MarioLulab/electronic_piano/HARDWARE/adc.c

#include "adc.h"



/*
                        光敏电阻
    PA1(ADC1/2_IN1) -> 电阻3
    PA3(ADC1/2_IN3) -> 电阻2
    PA4(ADC1/2_IN4) -> 电阻1
    PA5(ADC1/2_IN5) -> 电阻0

    初始化ADC
    不开启通道扫描
*/

void Adc_Init(void)
{ 	
	ADC_InitTypeDef ADC_InitStructure; 
	GPIO_InitTypeDef GPIO_InitStructure;

	RCC_APB2PeriphClockCmd(RCC_APB2Periph_GPIOA |RCC_APB2Periph_ADC1, ENABLE );	  //使能ADC1通道时钟
 

	RCC_ADCCLKConfig(RCC_PCLK2_Div6);   //设置ADC分频因子6 72M/6=12,ADC最大时间不能超过14M

	//PA1 作为模拟通道输入引脚                         
	GPIO_InitStructure.GPIO_Pin = GPIO_Pin_4 \
                                | GPIO_Pin_1 \
                                | GPIO_Pin_5 \
                                | GPIO_Pin_3 ;
	GPIO_InitStructure.GPIO_Mode = GPIO_Mode_AIN;		//模拟输入引脚
	GPIO_Init(GPIOA, &GPIO_InitStructure);	


	// 配置了4个通道，但是仍然禁用通道扫描，并且转换通道数仍设为1.
    // 这是因为在没有DMA的情况下，使用通道扫描会使ADCx->DR的数据重叠

	ADC_DeInit(ADC1);  //复位ADC1,将外设 ADC1 的全部寄存器重设为缺省值

	ADC_InitStructure.ADC_Mode = ADC_Mode_Independent;	//ADC工作模式:ADC1和ADC2工作在独立模式
	ADC_InitStructure.ADC_ScanConvMode = DISABLE;	//模数转换工作在单通道模式
	ADC_InitStructure.ADC_ContinuousConvMode = DISABLE;	//模数转换工作在单次转换模式
	ADC_InitStructure.ADC_ExternalTrigConv = ADC_ExternalTrigConv_None;	//转换由软件而不是外部触发启动
	ADC_InitStructure.ADC_DataAlign = ADC_DataAlign_Right;	//ADC数据右对齐
	ADC_InitStructure.ADC_NbrOfChannel = 1;	//顺序进行规则转换的ADC通道的数目
	ADC_Init(ADC1, &ADC_InitStructure);	//根据ADC_InitStruct中指定的参数初始化外设ADCx的寄存器   

  
	ADC_Cmd(ADC1, ENABLE);	//使能指定的ADC1
	
	ADC_ResetCalibration(ADC1);	//使能复位校准  
	 
	while(ADC_GetResetCalibrationStatus(ADC1));	//等待复位校准结束
	
	ADC_StartCalibration(ADC1);	 //开启AD校准
 
	while(ADC_GetCalibrationStatus(ADC1));	 //等待校准结束
 
//	ADC_SoftwareStartConvCmd(ADC1, ENABLE);		//使能指定的ADC1的软件转换启动功能
}	


//获得ADC值
//ch:通道值 0~3
uint16_t Get_Adc(uint8_t ch)   
{
  	//设置指定ADC的规则组通道，一个序列，采样时间
	ADC_RegularChannelConfig(ADC1, ch, 1, ADC_SampleTime_239Cycles5 );	//ADC1,ADC通道,采样时间为239.5周期. T = 239.5 * 1 / 12M = 20us	  			    
  
	ADC_SoftwareStartConvCmd(ADC1, ENABLE);		//使能指定的ADC1的软件转换启动功能	
	 
	while(!ADC_GetFlagStatus(ADC1, ADC_FLAG_EOC ));//等待转换结束

	return ADC_GetConversionValue(ADC1);	//返回最近一次ADC1规则组的转换结果
}


/*
    功能：获得指定通道的AD采样电压值
    输入：ch   : 通道名称
         times : 采样次数
*/
float Get_Adc_Average(uint8_t ch,uint8_t times)
{
	uint32_t temp_val=0;
	uint8_t t;
	for(t=0;t<times;t++)
	{
		temp_val+=Get_Adc(ch);
		Delay_ms(1);
	}

    uint16_t adcx = temp_val/times;

    float voltage = (float)adcx*(3.3/4096);  // 3.3是参考电压, 4096是因为ADC为12位

	// return (float)adcx;
    return voltage;
} 	 
